Dasovon/MyBot/docs/oled-display-reference.png

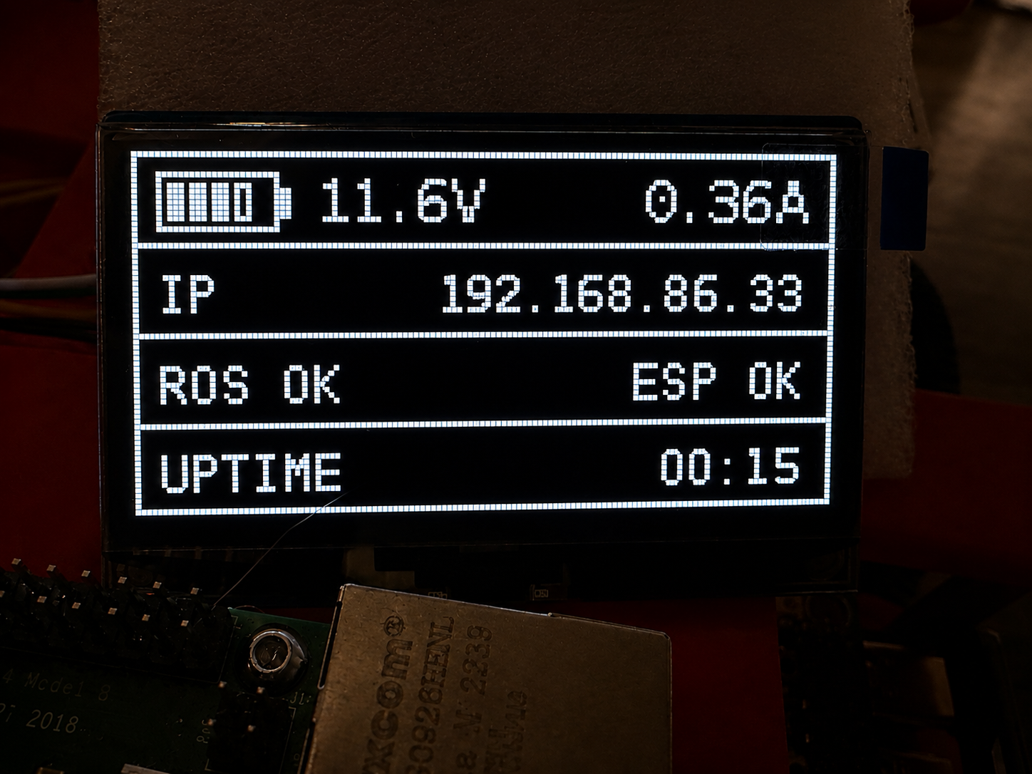
docs/oled-display-reference.png
