Dasovon/MyBot/Hardware/motor.png

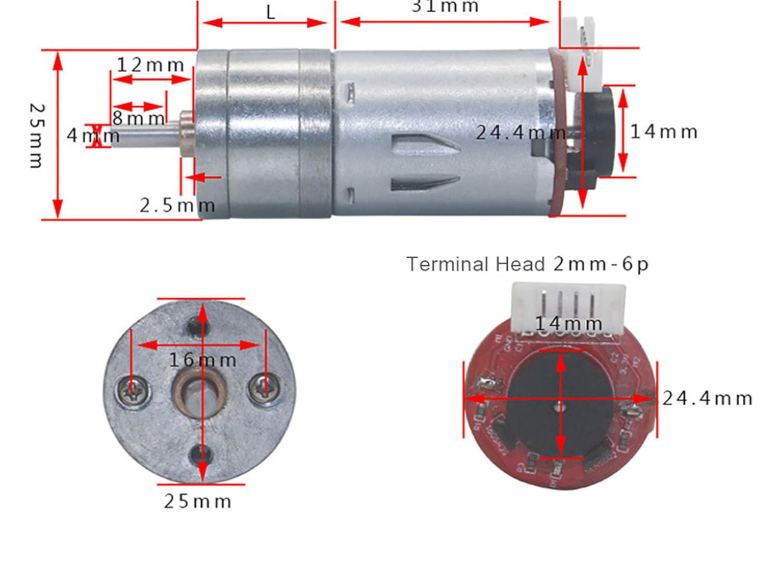
Hardware/motor.png
