Dasovon/MyBot/Hardware/mybot/mybot_back.png

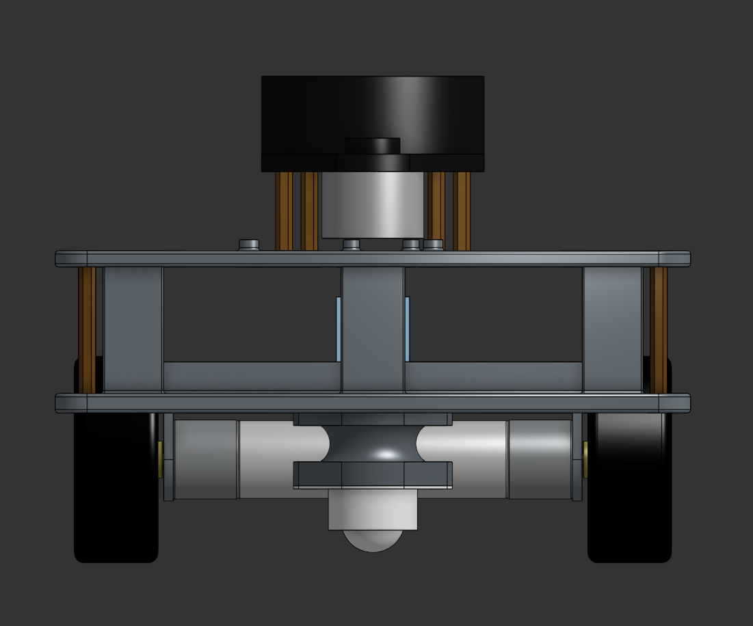
Hardware/mybot/mybot_back.png
