Dasovon/MyBot/Hardware/mybot/mybot_dim.png

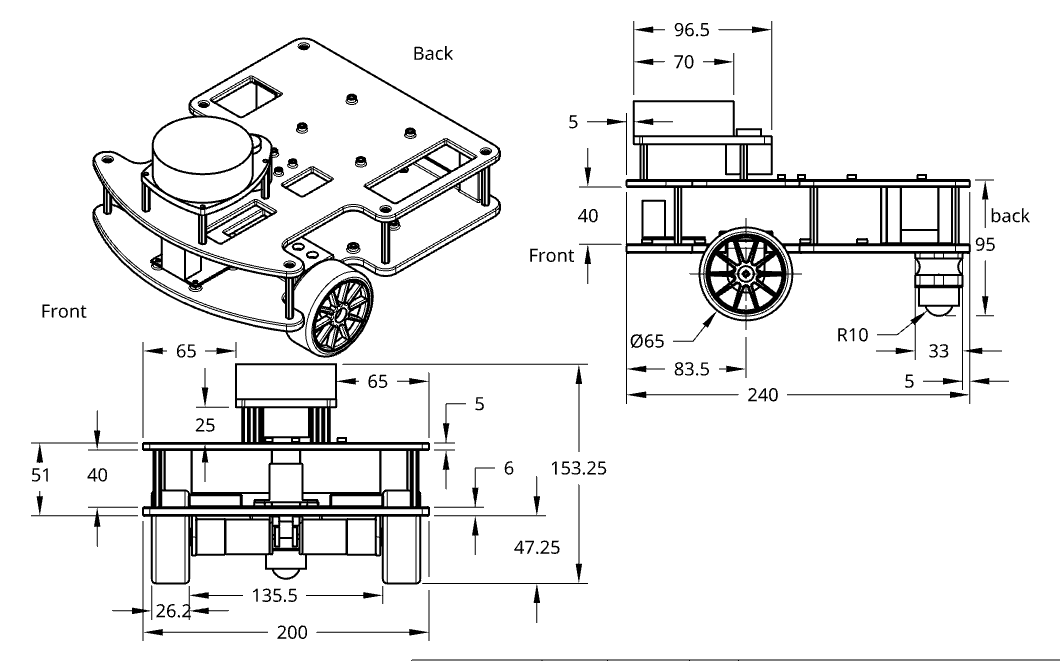
Hardware/mybot/mybot_dim.png
