Dasovon/MyBot/Hardware/mybot/mybot_left.png

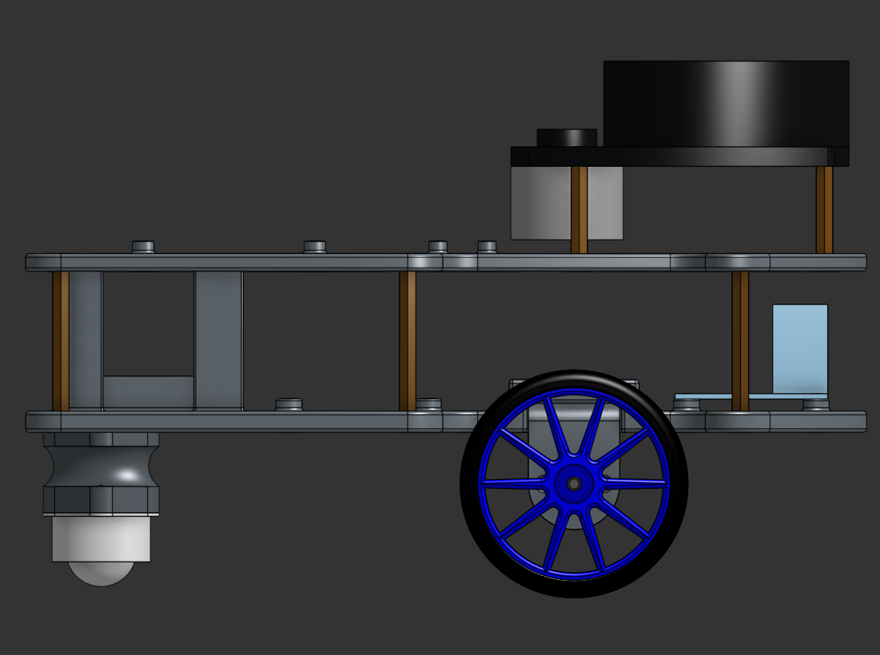
Hardware/mybot/mybot_left.png
