Dasovon/MyBot/docs/test-results/floor-tests/debug-command-path-2026-05-17/after-esp-recovery-attempt/floor_baseline_1_backward.csv

# test_date | 2026-05-17 18:24:48
# profile | one_turn
# command_topic | /cmd_vel_joy
# turn_revolutions | 4.681188
# turn_max_revolutions | 50.0
# turn_extend_revolutions | 1.0
# turn_linear_ms | -0.35
# turn_angular_rads | 0.0
# turn_velocity_floor | 0.5
# turn_adaptive | False
# turn_max_time_s | 14.0
# turn_counts_per_rev | 1010.0
# log_rate_hz | 5.0
# command_rate_hz | 10.0
# warmup_s | 0.5
wall_time | elapsed_s | run | phase | key | label | cmd_lin | cmd_ang | battery_v | current_a | power_w | raw_vx | raw_wz | ekf_vx | ekf_wz | imu_yaw_deg | imu_gyro_z | imu_accel_x | cmd_wheel_l | cmd_wheel_r | enc_cnt_l | enc_cnt_r | enc_tgt_l | enc_tgt_r | enc_act_l | enc_act_r | enc_filt_l | enc_filt_r | turn_goal_cnt
18:24:50 | 2.504 | 1 | active | i | one_turn | 0.0 | 0.0 | 12.12399959564209 | 0.3360000252723694 | 4.073664170537938 | 0.0 | 0.0 | nan | nan | -13.135969546990045 | -0.0625 | 0.06 | 0.0 | 0.0 | 0 | 0 | 0.0 | 0.0 | 0.0 | 0.0 | 0.0 | 0.0 | 4728
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
