Dasovon/MyBot/src/articubot_one/config/my_controllers.yaml

controller_manager:
  ros__parameters:
    update_rate: 30
    # use_sim_time: true

    diff_cont:
      type: diff_drive_controller/DiffDriveController

    joint_broad:
      type: joint_state_broadcaster/JointStateBroadcaster

diff_cont:
  ros__parameters:

    publish_rate: 50.0

    base_frame_id: base_link

    left_wheel_names: ['left_wheel_joint']
    right_wheel_names: ['right_wheel_joint']
    wheel_separation: 0.179
    wheel_radius: 0.034

    use_stamped_vel: false

    # open_loop: false    

    # wheels_per_side: x
    # wheel_separation_multiplier: x
    # left_wheel_radius_multiplier: x
    # right_wheel_radius_multiplier: x

    # odom_frame_id: x
    # pose_covariance_diagonal: x
    # twist_covariance_diagonal: x
    # open_loop: x
    # enable_odom_tf: x

    # cmd_vel_timeout: x
    # publish_limited_velocity: x
    # velocity_rolling_window_size: x
    

    linear.x.has_velocity_limits: true
    linear.x.has_acceleration_limits: true
    linear.x.max_velocity: 0.3
    linear.x.min_velocity: -0.3
    linear.x.max_acceleration: 0.5
    linear.x.min_acceleration: -0.5

    angular.z.has_velocity_limits: true
    angular.z.has_acceleration_limits: true
    angular.z.max_velocity: 3.35
    angular.z.min_velocity: -3.35
    angular.z.max_acceleration: 1.0
    angular.z.min_acceleration: -1.0




# joint_broad:
#   ros__parameters:
