Dasovon/MyBot/src/ros_arduino_bridge/ROSArduinoBridge/motor_driver.ino

/***************************************************************
   Motor driver definitions
   
   Add a "#elif defined" block to this file to include support
   for a particular motor driver.  Then add the appropriate
   #define near the top of the main ROSArduinoBridge.ino file.
   
   *************************************************************/

#ifdef USE_BASE
   
#ifdef POLOLU_VNH5019
  /* Include the Pololu library */
  #include "DualVNH5019MotorShield.h"

  /* Create the motor driver object */
  DualVNH5019MotorShield drive;
  
  /* Wrap the motor driver initialization */
  void initMotorController() {
    drive.init();
  }

  /* Wrap the drive motor set speed function */
  void setMotorSpeed(int i, int spd) {
    if (i == LEFT) drive.setM1Speed(spd);
    else drive.setM2Speed(spd);
  }

  // A convenience function for setting both motor speeds
  void setMotorSpeeds(int leftSpeed, int rightSpeed) {
    setMotorSpeed(LEFT, leftSpeed);
    setMotorSpeed(RIGHT, rightSpeed);
  }
#elif defined POLOLU_MC33926
  /* Include the Pololu library */
  #include "DualMC33926MotorShield.h"

  /* Create the motor driver object */
  DualMC33926MotorShield drive;
  
  /* Wrap the motor driver initialization */
  void initMotorController() {
    drive.init();
  }

  /* Wrap the drive motor set speed function */
  void setMotorSpeed(int i, int spd) {
    if (i == LEFT) drive.setM1Speed(spd);
    else drive.setM2Speed(spd);
  }

  // A convenience function for setting both motor speeds
  void setMotorSpeeds(int leftSpeed, int rightSpeed) {
    setMotorSpeed(LEFT, leftSpeed);
    setMotorSpeed(RIGHT, rightSpeed);
  }
#elif defined L298_MOTOR_DRIVER
  void initMotorController() {
    pinMode(LEFT_MOTOR_ENABLE,   OUTPUT);
    pinMode(LEFT_MOTOR_FORWARD,  OUTPUT);
    pinMode(LEFT_MOTOR_BACKWARD, OUTPUT);
    pinMode(RIGHT_MOTOR_ENABLE,  OUTPUT);
    pinMode(RIGHT_MOTOR_FORWARD, OUTPUT);
    pinMode(RIGHT_MOTOR_BACKWARD,OUTPUT);

    analogWrite(LEFT_MOTOR_ENABLE,  0);
    analogWrite(RIGHT_MOTOR_ENABLE, 0);
    digitalWrite(LEFT_MOTOR_FORWARD,  LOW);
    digitalWrite(LEFT_MOTOR_BACKWARD, LOW);
    digitalWrite(RIGHT_MOTOR_FORWARD,  LOW);
    digitalWrite(RIGHT_MOTOR_BACKWARD, LOW);
  }

  void setMotorSpeed(int i, int spd) {
    boolean reverse = false;

    if (spd < 0) {
      spd = -spd;
      reverse = true;
    }
    if (spd > 255) spd = 255;

    if (i == LEFT) {
      if (reverse) {
        digitalWrite(LEFT_MOTOR_FORWARD,  LOW);
        digitalWrite(LEFT_MOTOR_BACKWARD, HIGH);
      } else {
        digitalWrite(LEFT_MOTOR_FORWARD,  HIGH);
        digitalWrite(LEFT_MOTOR_BACKWARD, LOW);
      }
      analogWrite(LEFT_MOTOR_ENABLE, spd);
    } else {
      if (reverse) {
        digitalWrite(RIGHT_MOTOR_FORWARD,  LOW);
        digitalWrite(RIGHT_MOTOR_BACKWARD, HIGH);
      } else {
        digitalWrite(RIGHT_MOTOR_FORWARD,  HIGH);
        digitalWrite(RIGHT_MOTOR_BACKWARD, LOW);
      }
      analogWrite(RIGHT_MOTOR_ENABLE, spd);
    }
  }

  void setMotorSpeeds(int leftSpeed, int rightSpeed) {
    setMotorSpeed(LEFT, leftSpeed);
    setMotorSpeed(RIGHT, rightSpeed);
  }
#elif defined TB6612_MOTOR_DRIVER
  void initMotorController() {
    pinMode(LEFT_MOTOR_ENABLE,   OUTPUT);
    pinMode(LEFT_MOTOR_FORWARD,  OUTPUT);
    pinMode(LEFT_MOTOR_BACKWARD, OUTPUT);
    pinMode(RIGHT_MOTOR_ENABLE,  OUTPUT);
    pinMode(RIGHT_MOTOR_FORWARD, OUTPUT);
    pinMode(RIGHT_MOTOR_BACKWARD,OUTPUT);

    analogWrite(LEFT_MOTOR_ENABLE,  0);
    analogWrite(RIGHT_MOTOR_ENABLE, 0);
    digitalWrite(LEFT_MOTOR_FORWARD,  LOW);
    digitalWrite(LEFT_MOTOR_BACKWARD, LOW);
    digitalWrite(RIGHT_MOTOR_FORWARD,  LOW);
    digitalWrite(RIGHT_MOTOR_BACKWARD, LOW);
  }

  void setMotorSpeed(int i, int spd) {
    boolean reverse = false;

    if (spd < 0) {
      spd = -spd;
      reverse = true;
    }
    if (spd > 255) spd = 255;

    if (i == LEFT) {
      if (reverse) {
        digitalWrite(LEFT_MOTOR_FORWARD,  LOW);
        digitalWrite(LEFT_MOTOR_BACKWARD, HIGH);
      } else {
        digitalWrite(LEFT_MOTOR_FORWARD,  HIGH);
        digitalWrite(LEFT_MOTOR_BACKWARD, LOW);
      }
      analogWrite(LEFT_MOTOR_ENABLE, spd);
    } else {
      if (reverse) {
        digitalWrite(RIGHT_MOTOR_FORWARD,  LOW);
        digitalWrite(RIGHT_MOTOR_BACKWARD, HIGH);
      } else {
        digitalWrite(RIGHT_MOTOR_FORWARD,  HIGH);
        digitalWrite(RIGHT_MOTOR_BACKWARD, LOW);
      }
      analogWrite(RIGHT_MOTOR_ENABLE, spd);
    }
  }

  void setMotorSpeeds(int leftSpeed, int rightSpeed) {
    setMotorSpeed(LEFT, leftSpeed);
    setMotorSpeed(RIGHT, rightSpeed);
  }
#else
  #error A motor driver must be selected!
#endif

#endif
