Dasovon/MyBot/src/articubot_one/scripts/org01_font.py

#!/usr/bin/env python3

from PIL import Image, ImageDraw

GLYPH_DATA = {
    ' ': (0, 0, 6, 0, 1, []),
    '0': (5, 5, 6, 0, -4, ['#####', '#   #', '#   #', '#   #', '#####']),
    '1': (1, 5, 2, 0, -4, ['#', '#', '#', '#', '#']),
    '2': (5, 5, 6, 0, -4, ['#####', '    #', '#####', '#    ', '#####']),
    '3': (5, 5, 6, 0, -4, ['#####', '    #', '#####', '    #', '#####']),
    '4': (5, 5, 6, 0, -4, ['#   #', '#   #', '#####', '    #', '    #']),
    '5': (5, 5, 6, 0, -4, ['#####', '#    ', '#####', '    #', '#####']),
    '6': (5, 5, 6, 0, -4, ['#####', '#    ', '#####', '#   #', '#####']),
    '7': (5, 5, 6, 0, -4, ['#####', '    #', '    #', '    #', '    #']),
    '8': (5, 5, 6, 0, -4, ['#####', '#   #', '#####', '#   #', '#####']),
    '9': (5, 5, 6, 0, -4, ['#####', '#   #', '#####', '    #', '#####']),
    ':': (1, 4, 2, 0, -3, ['#', ' ', ' ', '#']),
    '.': (1, 1, 2, 0, 0, ['#']),
    'A': (5, 5, 6, 0, -4, ['#####', '#   #', '#####', '#   #', '#   #']),
    'B': (5, 5, 6, 0, -4, ['#### ', '#   #', '#### ', '#   #', '#### ']),
    'C': (5, 5, 6, 0, -4, ['#####', '#    ', '#    ', '#    ', '#####']),
    'D': (5, 5, 6, 0, -4, ['#### ', '#   #', '#   #', '#   #', '#### ']),
    'E': (5, 5, 6, 0, -4, ['#####', '#    ', '#####', '#    ', '#####']),
    'F': (5, 5, 6, 0, -4, ['#####', '#    ', '#####', '#    ', '#    ']),
    'G': (5, 5, 6, 0, -4, ['#####', '#    ', '# ###', '#   #', '#####']),
    'H': (5, 5, 6, 0, -4, ['#   #', '#   #', '#####', '#   #', '#   #']),
    'I': (5, 5, 6, 0, -4, ['#####', '  #  ', '  #  ', '  #  ', '#####']),
    'J': (5, 5, 6, 0, -4, [' ####', '   # ', '   # ', '#  # ', '#####']),
    'K': (5, 5, 6, 0, -4, ['#   #', '# ## ', '##   ', '# ## ', '#   #']),
    'L': (5, 5, 6, 0, -4, ['#    ', '#    ', '#    ', '#    ', '#####']),
    'M': (5, 5, 6, 0, -4, ['#####', '# # #', '# # #', '# # #', '# # #']),
    'N': (5, 5, 6, 0, -4, ['#####', '#   #', '#   #', '#   #', '#   #']),
    'O': (5, 5, 6, 0, -4, ['#####', '#   #', '#   #', '#   #', '#####']),
    'P': (5, 5, 6, 0, -4, ['#####', '#   #', '#####', '#    ', '#    ']),
    'Q': (5, 5, 6, 0, -4, ['#####', '#   #', '#   #', '#  ##', '#####']),
    'R': (5, 5, 6, 0, -4, ['#####', '#   #', '#####', '#  # ', '#  # ']),
    'S': (5, 5, 6, 0, -4, ['#####', '#    ', '#####', '    #', '#####']),
    'T': (5, 5, 6, 0, -4, ['#####', '  #  ', '  #  ', '  #  ', '  #  ']),
    'U': (5, 5, 6, 0, -4, ['#   #', '#   #', '#   #', '#   #', '#####']),
    'V': (5, 5, 6, 0, -4, ['#   #', '#   #', '#   #', ' # # ', '  #  ']),
    'W': (5, 5, 6, 0, -4, ['# # #', '# # #', '# # #', '# # #', '#####']),
    'X': (5, 5, 6, 0, -4, ['#   #', ' # # ', '  #  ', ' # # ', '#   #']),
    'Y': (5, 5, 6, 0, -4, ['#   #', '#   #', ' # # ', '  #  ', '  #  ']),
    'Z': (5, 5, 6, 0, -4, ['#####', '    #', '#####', '#    ', '#####']),
}


def text_width(text, scale=1.0):
    width = 0
    for ch in text:
        width += GLYPH_DATA.get(ch, GLYPH_DATA['?'] if '?' in GLYPH_DATA else GLYPH_DATA[' '])[2]
    return max(0, int(round(width * scale)))


def _draw_text_raw(draw, x, y, text, fill=0):
    baseline = y + 4
    cursor_x = x
    for ch in text:
        width, height, advance, x_off, y_off, rows = GLYPH_DATA.get(
            ch, GLYPH_DATA.get('?', GLYPH_DATA[' '])
        )
        if width and height:
            top = baseline + y_off
            left = cursor_x + x_off
            for row_idx, row in enumerate(rows):
                for col_idx, pixel in enumerate(row):
                    if pixel != '#':
                        continue
                    draw.point((left + col_idx, top + row_idx), fill=fill)
        cursor_x += advance
    return cursor_x - x


def draw_text(draw, x, y, text, fill=0, scale=1.0):
    if scale == 1.0:
        return _draw_text_raw(draw, x, y, text, fill=fill)

    width = max(1, text_width(text))
    height = 9
    base = Image.new('1', (width, height), 1)
    base_draw = ImageDraw.Draw(base)
    _draw_text_raw(base_draw, 0, 0, text, fill=0)
    scaled_w = max(1, int(round(base.width * scale)))
    scaled_h = max(1, int(round(base.height * scale)))
    scaled = base.resize((scaled_w, scaled_h), resample=Image.NEAREST)
    for py in range(scaled_h):
        for px in range(scaled_w):
            if scaled.getpixel((px, py)) == 0:
                draw.point((x + px, y + py), fill=fill)
    return scaled_w
