Dasovon/MyBot/(commit log)

2026-03-16 Initial commit — MyBot ROS 2 Humble workspace
    - articubot_one package (launch, config, description, URDF)
    - ROSArduinoBridge Arduino firmware (L298N + encoder wiring for DC12V 130RPM motors)
    - Hardware documentation and memory files
    - Encoder calibration helper script
    - enc_counts_per_rev updated to 1100 for new motors (pending odom validation)
    [ball_tracker_params_robot.yaml, camera.xacro, depth_camera.xacro, face.xacro, gazebo_control.xacro, inertial_macros.xacro, lidar.xacro, my_controllers.yaml]
2026-03-17 Motor swap, odometry validation, and URDF update to actual dimensions (2026-03-16)
    Motors:
    - Swapped to JGA25-371 45:1 DC12V 130RPM encoder gear motors
    - enc_counts_per_rev validated at 990 via odometry (two runs)
    - Needs re-validation after wheel_radius correction
    URDF / config corrections (robot_core.xacro, lidar.xacro, my_controllers.yaml):
    - wheel_separation: 0.297 → 0.179m (measured center-to-center)
    - wheel_radius: 0.0325 → 0.034m (measured 68mm; datasheet says 65mm)
    - chassis_length: 0.335 → 0.240m
    - chassis_width: 0.265 → 0.1355m
    - wheel_offset_y: 0.1485 → 0.0895m
    - caster_wheel_offset_x: 0.075 → 0.033m
    - lidar xyz: 0.122,0,0.212 → 0.200,0,0.116 (40mm from front, 160mm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
    [lidar.xacro, my_controllers.yaml, robot_core.xacro, ros2_control.xacro]
2026-03-18 Re-validate enc_counts_per_rev with corrected wheel_radius
    3 wall-guided odometry runs (2026-03-17) with wheel_radius=0.034:
    - Run 1: 29.25in actual → 1006
    - Run 2: 37.5in actual → 1016
    - Run 3: 33.625in actual → 1012
    - Average: 1011 → applied 1010
    Previous value of 990 was measured before wheel_radius correction from
    0.0325 → 0.034m (~4.6% scale change). CLAUDE.md updated accordingly.
    [ros2_control.xacro]
2026-03-18 Add RPLidar A1 support and stable USB device names
    - Create udev rules: /dev/arduino (CH340) and /dev/rplidar (CP2102)
    - Update ros2_control.xacro: device /dev/ttyUSB0 → /dev/arduino
    - Update rplidar.launch.py: use /dev/rplidar, add serial_baudrate=115200
    - Lidar verified: health OK, Standard mode, 10Hz scan frequency
    [ros2_control.xacro]
2026-03-18 Fix robot model orientation and add RPLidar to main launch
    URDF orientation fix (chassis was drawn backwards):
    - chassis_joint: add rpy="0 0 pi" rotation, adjust x to chassis_length-wheel_offset_x
    - caster_wheel_offset_x: 0.033 -> 0.207 (now measured from front in flipped chassis frame)
    - lidar.xacro: origin x 0.200 -> 0.040 (40mm from front edge in flipped frame)
    - robot.urdf.xacro: comment out face.xacro inclusion
    RPLidar integration:
    - launch_robot.launch.py: include rplidar.launch.py in main launch
    [lidar.xacro, robot.urdf.xacro, robot_core.xacro]
2026-03-18 Update CLAUDE.md: lidar done, SLAM next
2026-03-18 Update CLAUDE.md: fix history #12, serial device, session notes
2026-03-19 Add SLAM, BNO055 IMU, and robot_localization EKF
    - SLAM with slam_toolbox: fixed mode→mapping, use_sim_time→false,
    max_laser_range→12.0, minimum_travel_distance/heading→0.2
    - Saved map: maps/my_map.pgm + my_map.yaml (200x136 @ 0.05m/pix)
    - BNO055: ros-humble-bno055 on I2C bus 1 at 0x28, config/bno055_params.yaml
    - robot_localization EKF: fuses /diff_cont/odom + /imu/imu → /odom at 20Hz
    - imu_link added to URDF at xyz="0.004 -0.018 0.055"
    - Removed old /diff_cont/odom→/odom remap; EKF now owns /odom
    - Updated CLAUDE.md (fix history #13, #14) and HARDWARE_MEMORY.md
    - Added BNO055 datasheet to Hardware/
    [robot_core.xacro]
2026-03-21 Add RealSense D435, offload EKF/Nav2 to dev machine, tune SLAM and Nav2
    - Add camera.launch.py for RealSense D435 (640x480@15fps, no pointcloud)
    - Add dev_launch.py: runs EKF on dev machine to reduce Pi CPU load
    - Remove EKF from launch_robot.launch.py (now runs on dev)
    - Add Nav2 stack (localization + navigation launch files, Humble API)
    - Raise Nav2 max velocity to 0.4 m/s (was TurtleBot3 default 0.26)
    - Tune SLAM params for small rooms (minimum_time_interval, link_match, loop_match)
    - Update map: 113x140 @ 0.05m/pix (2026-03-21)
    - Update CLAUDE.md: fix #16-18, current status, dev architecture
    [mapper_params_online_async.yaml]
2026-03-22 Fix RealSense D435 color stream and add ball tracker
    - Fix #18 complete: built librealsense v2.56.4 from source with
    FORCE_RSUSB_BACKEND=ON; replaced apt .so in /opt/ros/humble to
    override V4L2/UVC backend — both depth and color streams now at 15 FPS
    - Clone ball_tracker (joshnewans) into dev_ws; fix image_topic remap
    from /camera/image_raw → /camera/camera/color/image_raw for D435
    - CLAUDE.md: update status, document fix #18 steps and key lessons,
    mark "Adding a Camera" tutorial chapter complete
2026-04-26 Switch motor driver from L298N to Adafruit TB6612
    Add TB6612_MOTOR_DRIVER ifdef block with same pin mapping (D5/D6/D7/D8/D9/D10)
    and identical PWM+direction logic. Same physical wiring, different driver chip.
2026-04-26 Docs: update for TB6612 motor driver swap
    Update CLAUDE.md and HARDWARE_MEMORY.md to reflect Adafruit TB6612
    replacing L298N — pin mapping, firmware define, fix history, block diagram.
2026-04-26 Docs: TB6612 first unit damaged by overvoltage on AIN1/BIN1
    Document root cause (12V on logic input pins), symptoms, diagnosis method,
    and what to check before installing replacement chip.
2026-04-26 Fix TB6612 pin mapping: swap motors and invert direction
    Encoder tests revealed PWMA/AIN drives right motor and PWMB/BIN drives
    left motor (physically swapped). xIN2=HIGH is forward for both channels.
    [motor_driver.h]
2026-04-26 Fix TB6612 wiring table left/right label flip; document VCC logic thresholds
    Motor A (PWMA/AIN1/AIN2) drives the RIGHT motor and Motor B (PWMB/BIN1/BIN2)
    drives the LEFT motor — the wiring table had these labels swapped relative to
    the firmware pin defines. Also adds VCC to the wiring table with a note that
    all TB6612 signal thresholds are validated against VCC, so it must match MCU
    logic voltage (5V for Arduino Nano; 3.3V for ESP32, no level shifter needed).
    https://claude.ai/code/session_01JZxLh9r5mjwfbjnuEyVAhU
2026-04-26 Add ESP32 micro-ROS firmware scaffold (motor control + BNO055)
    Self-contained PlatformIO project in src/esp32_microros/. No existing
    files touched. Publishes /diff_cont/odom and /imu/imu, subscribes to
    /diff_cont/cmd_vel_unstamped — same topics as current Arduino stack so
    Pi-side EKF, Nav2, and AMCL require no changes.
    PID gains seeded from validated Arduino values (Kp=20, Kd=12, Ki=0).
    Encoder ISR direction matches fix #7. Requires micro_ros_agent on Pi:
    ros2 run micro_ros_agent micro_ros_agent serial --dev /dev/ttyUSB0
    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
    [main.cpp]
2026-04-26 Update docs and README for ESP32 micro-ROS branch
    - README: rewrite to reflect current hardware (TB6612 not L298N, Nav2
    working, BNO055, RealSense); add esp32_microros to workspace structure
    - HARDWARE_MEMORY: fix motor channel labels (Motor A = RIGHT, Motor B = LEFT);
    add full ESP32 wiring tables and micro-ROS agent command
    - docs/workflow.md: add ESP32 micro-ROS testing section with flash, verify,
    and switchback instructions
    - docs/pin-mapping.md: new file — full pin tables for both Arduino and ESP32
    hardware paths, GPIO caveats, ISR direction notes
    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
2026-04-26 Add ESP32 component test sketches
    Four standalone PlatformIO projects in src/esp32_microros/test/:
    - test_bno055: I2C reads, quaternion/gyro/accel output, calibration status
    - test_encoders: pulse counting with velocity estimate, direction mismatch
    detection, 'r' to reset
    - test_motors: safety-gated test sequence (forward/reverse per motor, PWM
    ramp), manual f/b/l/r/s control; includes pre-flight checklist for
    replacement TB6612 chip
    - test_microros: agent connection state machine with LED feedback, heartbeat
    counter on /esp32/heartbeat, cmd_vel subscriber; Pi-side verify commands
    in comments
    Each sketch is independent — no micro-ROS dependency except test_microros.
    https://cl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
    [main.cpp]
2026-04-26 Update CLAUDE.md with 2026-04-26 session work
    - Where we are now: update date, TB6612 status, ESP32 branch status, ordered next steps
    - Active branches: add feature/esp32-microros and claude/document-vcc-logic-thresholds
    - Directory structure: add esp32_microros/ tree with test sketch layout
    - Current status: add ESP32 experiment entry and label fix entry
    - Fix #20: TB6612 wiring table label correction (Motor A=RIGHT, Motor B=LEFT)
    - Fix #21: ESP32 micro-ROS scaffold — pin mapping, topics, flash commands, status
    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
2026-04-26 Add test_bno055 sketch for ESP32 I2C validation
    Standalone PlatformIO sketch (no micro-ROS) that confirms BNO055
    is wired and responding before flashing full firmware.
    https://claude.ai/code/session_01DwZ5af26dRz936bHStCzpJ
2026-04-27 Update CLAUDE.md: ESP32 test session 2026-04-27
    - Status updated: Windows machine set up, test_bno055 flashed to ESP32
    - Next steps updated: BNO055 wiring → encoder test → motor test → micro-ROS
    - Fix #22 added: Windows dev setup + test_bno055 sketch details
    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
2026-05-03 fix(firmware): restore TB6612 right motor pins and fix left encoder direction
    Replacement TB6612 motor wiring was corrected — both wires now on MOTORA/MOTORB
    output pads (not GND pad). Right motor Arduino pins reverted from debug-test
    positions (D11/A0/A1) to original D5/D6/D7. Left encoder ISR inverted (A==B →
    A!=B) so forward rotation gives positive counts. All four directions validated.
    [encoder_driver.ino, motor_driver.h]
2026-05-03 fix(firmware): invert left motor direction and restore left encoder ISR
    Left wheel was running backward — robot rotated instead of driving forward.
    Swapped LEFT_MOTOR_FORWARD/BACKWARD (BIN1↔BIN2) and reverted left encoder
    ISR back to A==B to keep positive counts for forward rotation. Validated:
    robot drives forward on 'i', turns correctly on 'j'/'l'.
    [encoder_driver.ino, motor_driver.h]
2026-05-03 docs: update CLAUDE.md with teleop validation and final motor direction fix
2026-05-03 tune: lower linear max to 0.3 m/s, raise angular max to 2.5 rad/s
    Balances teleop feel — forward was faster than turns because angular cap
    was 1.0 rad/s and all teleop values above it got clamped to the same speed.
    [my_controllers.yaml]
2026-05-03 tune: match angular max to linear max wheel speed (3.35 rad/s)
    angular_max = 2 * linear_max / wheel_separation = 2 * 0.3 / 0.179 = 3.35
    This ensures full-speed turning uses the same wheel velocity as full-speed
    straight driving.
    [my_controllers.yaml]
2026-05-04 docs: update all hardware docs with TB6612 validation and velocity tuning
    - CLAUDE.md: fix #21 entry, updated current status to 2026-05-03
    - HARDWARE_MEMORY.md: motor driver status, correct FORWARD/BACKWARD pins,
    velocity tracking validation results
    - docs/pin-mapping.md: corrected firmware pin defines (BIN1=FWD, BIN2=BWD),
    motor output wiring warning, velocity tracking data
2026-05-04 docs: add final velocity tracking validation data (3 confirmed runs)
    Forward and spin track 88-98% at operating speeds, symmetric within
    0.002 m/s left/right. Low-speed deadband at 25% is normal for DC motors.
2026-05-04 docs: add IMU axis validation and circle test results
    BNO055 axes confirmed (x=forward, z=yaw). Circle test: 0.94 IMU/cmd
    ratio, 24.6 cm closure error open-loop. README updated with current
    validated status table.
2026-05-04 docs: update next steps — lidar test + sensor calibration next session
2026-05-05 launch: disable camera node when not connected
2026-05-05 ekf: add process noise covariance matrix to fix numerical instability
    [ekf.yaml]
2026-05-05 amcl: tune params for better localization convergence
    Increase particles 2000→5000, update thresholds 0.25/0.2→0.1/0.1,
    tighten laser model (sigma_hit 0.2→0.1, z_hit 0.5→0.8, z_rand 0.5→0.15),
    enable recovery (alpha_fast=0.1, alpha_slow=0.001).
2026-05-05 docs: update status — nav stack validated 2026-05-04
2026-05-05 docs: add Nav2 navigation test and Jetson Nano to next steps
2026-05-05 session 2026-05-05: new map, Nav2 goal confirmed, architecture clarified
    - New room map saved: 232x321 @ 0.025 m/pix
    - Nav2 autonomous goal send → SUCCEEDED
    - Clarified current architecture: Arduino = motor driver only,
    BNO055 on Pi I2C-1 (temporary), ESP32 migration pending
    - All sensors verified healthy (RPLIDAR, Arduino, BNO055)
    - Copied map files to dev machine ~/mybot_ws/maps/
2026-05-05 re-enable RealSense camera in launch_robot.launch.py
    D435 re-connected — uncomment camera node.
2026-05-05 auto USB reset for RealSense D435 on launch
    - Add uhubctl power cycle (hub 2 port 2) as first launch action
    - Camera node delayed 6s to allow USB re-enumeration
    - Eliminates need for physical replug after Pi reboot
2026-05-05 increase RealSense USB reset and launch delays
    Power cycle: off 3s → on 6s wait (was 2s/3s)
    Camera launch delay: 6s → 12s after reset completes
2026-05-05 wait for D435 USB enumeration in reset script, bump camera delay to 20s
2026-05-05 add initial_reset to RealSense camera launch
    Forces firmware reset before streaming to fix color stream XU
    control failures after repeated node restarts.
2026-05-05 force camera image topics to VOLATILE QoS
    TRANSIENT_LOCAL was incompatible with image_transport, rqt_image_view,
    and standard ROS 2 subscribers. VOLATILE allows compressed republishing
    and normal topic tools to work across the network.
2026-05-05 fix(camera): disable IR streams, remove initial_reset, add VOLATILE QoS for network image transport
    Fixes RealSense D435 streaming to dev machine (fix #24):
    - Remove initial_reset:true — caused soft re-enumeration that broke color sensor XU state
    - Disable IR streams (enable_infra1/2: false) — not needed for object tracking, fits USB 2.0 bandwidth
    - Add VOLATILE QoS overrides on color + depth topics — fixes DDS incompatibility with cross-network subscribers
    - Update CLAUDE.md with USB authorization reset approach and camera streaming status
    USB reset approach is in ~/reset_realsense.sh on Pi (not in git):
    uses echo 0/1 to /sys/bus/usb/devices/*/authorized to clear endpoint stalls with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
2026-05-08 feat(ina219): add battery state publisher node via Pi I2C
    - ina219_node.py: reads voltage + current from INA219 at 0x40 (I2C bus 1),
    publishes sensor_msgs/BatteryState on /battery_state at 1Hz
    - CMakeLists.txt: install scripts/ina219_node.py as executable
    - launch_robot.launch.py: add ina219 node to Pi launch
    INA219 (ACEIRMC, 0.1Ω shunt) wired to Pi I2C-1 (GPIO 2/3),
    shares bus with BNO055 at 0x28. INA219 address 0x40.
2026-05-08 docs: session wrap-up 2026-05-07 — INA219 confirmed working
    11.38V / +0.21A at idle verified. Correct polarity (VIN+ on battery+).
2026-05-10 feat(esp32): update test_bno055 sketch for ESP32-S3-DevKitC-1
    Switch board from esp32dev to esp32-s3-devkitc-1 and update I2C pins
    from GPIO21/22 (not broken out on S3) to GPIO8/9 (default S3 I2C).
    BNO055 confirmed working on Lonely Binary expansion base.
    [main.cpp]
2026-05-10 Revert "feat(esp32): update test_bno055 sketch for ESP32-S3-DevKitC-1"
    This reverts commit 27e644cb50d7cc14c79be0bad9b0c8e4cdeea19e.
    [main.cpp]
2026-05-10 feat(esp32): add WiFi OTA to test_bno055 sketch
    ArduinoOTA on hostname esp32-mybot. USB env (esp32-s3) unchanged;
    new env esp32-s3-ota uploads via espota to esp32-mybot.local.
    credentials.h gitignored — fill in SSID/password locally before
    first USB flash.
2026-05-10 feat(esp32): add WiFi OTA, telnet monitor, and INA219 to test_bno055
    - ArduinoOTA over WiFi (hostname esp32-mybot, port espota)
    - TelnetStream on port 23 for wireless serial monitoring (nc esp32-mybot.local 23)
    - INA219 battery monitor on shared I2C bus (0x40) confirmed working
    - BNO055 + INA219 both confirmed on ESP32-S3 at 11.4V / ~40-70mA
    - credentials.h gitignored — fill in locally before first USB flash
2026-05-10 docs: update CLAUDE.md with ESP32 status and Windows dev setup
    - Current status: BNO055 + INA219 confirmed on ESP32-S3, OTA + telnet working
    - Windows setup: CH340 driver, VS Code + PlatformIO, clone/checkout steps,
    credentials.h instructions, first USB flash and OTA workflow
    - gitignore: add .vscode/ for esp32_microros sketches
2026-05-10 docs: overhaul README, CLAUDE.md, and add esp32_microros README
    - README.md: full rewrite with badges, status table, power architecture
    diagram, hardware table (DFR0205 added), architecture ASCII, and
    per-sketch ESP32 test status
    - src/esp32_microros/README.md: new embedded project README covering
    pin mapping, bench test progression, OTA flash workflow, and
    micro-ROS topic reference
    - CLAUDE.md: merged concise CLAUDE_1.md structure with full fix history,
    Windows ESP32 dev setup, Windows machine added to machines table,
    INA219 added to ESP32 pin mapping (GPIO8/9 shared with BNO055)
    - HARDWARE_MEMORY.md: power architecture updated with DFR0205 details
    and full power chain (batter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
2026-05-10 docs(hardware): add full component reference library
    New Hardware/ folder structure with docs for all 10 components:
    - Hardware/README.md — master index, system block diagram, power budget
    - compute/raspberry-pi-4.md — GPIO pinout, USB assignments, udev, I2C devices
    - compute/arduino-nano.md — pinout, motor/encoder wiring, firmware, flash cmd
    - microcontroller/esp32-s3-devkitc-1.md — pin assignments, OTA workflow, GPIO restrictions
    - motor-system/tb6612-driver.md — full pinout, direction table, Arduino+ESP32 wiring, damage warning
    - motor-system/jga25-371-motors.md — wire colors, encoder ISR, odometry formula
    - sensors/bno055-imu.md — Pi + ESP32 wiring, ROS con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
2026-05-10 docs(hardware): add DFR0205 board diagram with white background
    White background added so annotation text is readable in both light
    and dark markdown preview themes.
2026-05-10 fix(esp32): retry INA219 begin() on boot failure
    INA219 was silently failing begin() on some boots despite being present
    on I2C. Added same retry-loop pattern as BNO055.
    [main.cpp]
2026-05-10 fix(esp32): correct pin assignments for ESP32-S3 in test_encoders and test_motors
    GPIO25/26/27/32/33/34/35/36/39 don't exist on ESP32-S3. Updated to valid S3 pins:
    - TB6612: PWMA=1, AIN1=2, AIN2=4, PWMB=5, BIN1=6, BIN2=7
    - Encoders: L_A=40, L_B=41, R_A=42, R_B=43
    - Updated CLAUDE.md pin table
    [main.cpp]
2026-05-10 fix(esp32): correct pins for Lonely Binary expansion base
    GPIO4/5/6/7 not broken out on this board. Updated to available pins:
    - TB6612: PWMA=10, AIN1=11, AIN2=12, PWMB=13, BIN1=14, BIN2=15 (left side)
    - Encoders: L_A=40, L_B=41, R_A=42, R_B=39 (right side)
    - Updated CLAUDE.md with board pin layout
    [main.cpp]
2026-05-10 feat(esp32): add WiFi OTA and telnet to test_encoders and test_motors
    - Board corrected to esp32-s3-devkitc-1 (was esp32dev)
    - ArduinoOTA + TelnetStream on port 23
    - Commands (r / f b l r s g) work from both USB serial and telnet
    - credentials.h gitignored — copy from test_bno055/src/
    [main.cpp]
2026-05-10 fix(esp32): use legacy LEDC API in test_motors
    ledcAttach() is new API (core 3.x+). Replace with ledcSetup/ledcAttachPin/ledcWrite
    using explicit channels. Motors confirmed working on ESP32-S3.
    [main.cpp]
2026-05-10 feat(esp32): update test_microros for WiFi UDP transport + OTA + telnet
    - Board: esp32-s3-devkitc-1 (was esp32dev)
    - Transport: WiFi UDP to Pi agent at 192.168.86.33:8888 (was UART)
    - Added ArduinoOTA + TelnetStream for wireless flashing and monitoring
    - Agent start command: ros2 run micro_ros_agent micro_ros_agent udp4 --port 8888
2026-05-10 test_microros: switch to USB serial transport via micro_ros_platformio
    Replaces micro_ros_arduino (no ESP32-S3 precompiled lib) with
    micro_ros_platformio which builds libmicroros.a for the exact target.
    Transport changed from WiFi UDP to USB serial (HWCDC via ttyACM0).
    ARDUINO_USB_CDC_ON_BOOT=1 routes Serial to the native USB JTAG port.
    WiFi retained for OTA flashing and TelnetStream monitoring only.
    Ping timeout increased 100ms/1 → 500ms/3 for stable HWCDC link.
    [main.cpp]
2026-05-10 docs: update all docs with ESP32-S3 bench test results and USB transport
    - CLAUDE.md: status updated to 2026-05-10 with all bench tests confirmed;
    fixes #22 (Lonely Binary pin corrections) and #23 (micro_ros_platformio +
    HWCDC USB transport, penv workaround, ping timeout fix); agent command
    updated to ttyACM0 with microros_ws source
    - docs/pin-mapping.md: replaced stale ESP32-DevKitC section with correct
    Lonely Binary Expansion Base pins (GPIO10-15 motors, GPIO39-42 encoders,
    GPIO8/9 I2C); LEDC legacy API note; HWCDC transport details
    - HARDWARE_MEMORY.md: replaced placeholder ESP32 wiring block with validated
    Lonely Binary pin assignments and USB transport setup
    - README.md: sta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
2026-05-10 esp32: full production firmware — encoders + PID + odom + BNO055 + INA219 + micro-ROS
    Replaces scaffold with complete firmware combining all validated components.
    Correct ESP32-S3 board, micro_ros_platformio library, HWCDC serial transport,
    WAITING/CONNECTED state machine, 30Hz control loop, 1Hz battery publish.
    [main.cpp]
2026-05-10 feat(launch): replace ros2_control/bno055 with ESP32 micro_ros_agent
    Remove controller_manager, diff_drive_spawner, joint_broad_spawner,
    and bno055 node. Add micro_ros_agent node (serial /dev/ttyACM0).
    ESP32 now owns odometry, IMU, and battery monitoring.
2026-05-11 Fix motor cross-wiring runaway, retune PID, add coast-to-stop; migrate Pi launch to micro_ros_agent
    - Revert PWMA/PWMB swap that created cross-coupled positive feedback loop
    - Reduce Kp 100→30 to prevent turn oscillation; retain Ki=150 for deadband
    - Add coast-to-stop: PID returns 0 when target<0.01 (no hard braking jerk)
    - Migrate launch_robot.launch.py from ros2_control to micro_ros_agent
    - CLAUDE.md: document fixes #25/#26, update status to driving validated
    [main.cpp]
2026-05-11 Update hardware docs to reflect ESP32-S3 production stack
    - esp32-s3-devkitc-1.md: correct GPIO pins (TB6612: 10-15, enc: 40/41/42/39), HWCDC transport (ttyACM0), 30Hz topic rates, pins-to-avoid table
    - tb6612-driver.md: correct ESP32 GPIO pins in wiring table, mark as production
    - raspberry-pi-4.md: update node list (micro_ros_agent replaces ros2_control stack), USB table (ttyACM0), remove Pi I2C section (moved to ESP32)
    - Hardware/README.md: update system diagram, ESP32-S3 → Production, Arduino Nano → Retired, power budget
    - HARDWARE_MEMORY.md: update system block diagram and bringup sequence for ESP32 stack
    - docs/workflow.md: update what-runs-where, emergency stop procedure, ESP32 se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
2026-05-14 docs(esp32): fix README — correct pins, status, rates, agent device
    - Motor pins updated to Lonely Binary base: PWMA/B→10/13, AIN/BIN→11/12/14/15
    - Encoder pins updated: L_A/B→40/41, R_A/B→42/39
    - All test sketch status: ⬜ pending → ✅ confirmed (validated 2026-05-09/10)
    - Publish rates: ~20 Hz → ~30 Hz (matches 33ms control loop)
    - Agent device: /dev/ttyUSB0 → /dev/ttyACM0 (HWCDC native USB)
    - Pins to avoid: updated for ESP32-S3 + Lonely Binary board constraints
    - I2C note: updated to explain Lonely Binary unexposed GPIOs
    - Library: micro_ros_arduino → micro_ros_platformio
2026-05-14 docs(display): update OLED docs to SPI mode with official Waveshare pinout
    - Switch all wiring from I2C to SPI (no resistor swap needed — module ships in SPI)
    - Correct DC→GPIO25 (pin 22) and RST→GPIO27 (pin 13) from official Waveshare wiki
    - Update luma.oled code to spi() interface with correct gpio_DC/gpio_RST
    - Add product photo (oled-2.42inch.png)
    - Add display to Hardware/README.md component index, power budget, and system diagram
2026-05-14 docs(display): add wire colors to OLED wiring tables
    Red=VCC, Black=GND, Blue=DIN, Yellow=CLK, Orange=CS, Green=DC, White=RST
2026-05-14 feat(display): add OLED display ROS 2 node
    oled_display_node.py subscribes to /battery_state, /diff_cont/odom,
    /odom (EKF), and /navigate_to_pose/_action/status, then renders a
    5-line 128x64 status dashboard at 2 Hz via luma.oled SPI (ssd1309,
    GPIO25=DC, GPIO27=RST).
    Layout: hostname/IP | battery V+A | velocity | EKF pose | status line
    Status line: AGENT OFFLINE / TELEOP / IDLE / NAVIGATING / GOAL REACHED
2026-05-14 fix: mark oled_display_node.py executable
    [oled_display_node.py]
2026-05-14 fix: switch OLED interface from SPI to I2C
    Module resistors (R2/R3) are in the I2C position from the factory.
    Wire change: DIN→pin3(SDA), CLK→pin5(SCL), CS→GND.
    DC pin stays at GPIO25 (I2C address select, LOW=0x3C).
    [oled_display_node.py]
2026-05-14 fix: revert OLED to SPI — resistors confirmed in SPI position
    Module is SPI from factory. DC wire (green) was on wrong pin
    (pin 21 MISO instead of pin 22 GPIO25). Code reverts to SPI interface.
    [oled_display_node.py]
2026-05-14 fix: rewrite OLED node using spidev+RPi.GPIO, drop luma.oled
    luma.oled ssd1309 is an alias for ssd1306 — sends SSD1306 charge pump
    command (0x8D 0x14) which corrupts SSD1309 init. Replaced with bare-metal
    spidev + RPi.GPIO using the correct Waveshare SSD1309 init sequence.
    Page-based pixel rendering matches Waveshare convention (black=lit).
    [oled_display_node.py]
2026-05-14 docs: update OLED docs and CLAUDE.md — display working
    - Hardware doc: replace luma.oled instructions with correct spidev approach,
    document why luma.oled fails on SSD1309 (SSD1306 charge pump command)
    - CLAUDE.md: mark OLED display complete, update date to 2026-05-14
2026-05-14 fix: use UDP socket trick to get real network IP on display
    socket.gethostbyname(hostname) returns 127.0.1.1 on Ubuntu due to
    /etc/hosts. UDP connect to 8.8.8.8 asks the OS routing table for
    the correct outbound interface IP without sending any packets.
    [oled_display_node.py]
2026-05-14 docs: document Waveshare 2.42" OLED implementation (2026-05-14)
    Add complete OLED hardware/software documentation. Key decisions:
    - spidev + RPi.GPIO directly (not luma.oled — its ssd1309 class is broken)
    - systemd service at boot, not in launch_robot.launch.py
    - UDP socket trick for real network IP on Ubuntu 22.04
    Also updates BNO055 section to reflect move from Pi I2C to ESP32 I2C,
    corrects power architecture diagram, and marks OLED status as Production.
2026-05-14 fix: add 4px left margin on OLED display to prevent character clipping
    DejaVu Sans V/W/Y strokes clip at x=0; 4px margin prevents cutoff.
    [oled_display_node.py]
2026-05-14 fix: hold RST LOW before SPI open to prevent spurious boot init failure
    On first boot GPIO27 (RST) is a floating input, letting the SSD1309
    receive noise when the SPI clock transitions to its mode-3 idle state.
    Fix: drive RST LOW with initial=GPIO.LOW before opening spidev, then
    hold for 100ms before the reset pulse, and extend post-reset settle to
    200ms. Adds 'Display init OK' log to confirm completion.
    [oled_display_node.py]
2026-05-14 debug: fill display inside _init_display to isolate boot SPI issue
    [oled_display_node.py]
2026-05-14 debug: replace fill with 0xA5 (entire display ON) to test command path
    [oled_display_node.py]
2026-05-14 docs: session end — document OLED boot bug and Pi SD card status
    oled-display.service disabled on Pi. SD card likely corrupted from
    rapid reboots during debug. OLED works after systemctl restart but
    not on first boot — root cause unknown, key facts documented.
2026-05-15 docs: session end — Pi fully restored, OLED hardware issue identified
    Pi reflashed and fully restored (ROS Humble, mybot_ws, microros_ws,
    librealsense RSUSB, udev rules). Robot stack confirmed running with
    ESP32-S3. OLED: RST wire was on wrong pin (11→13 fixed), all software
    paths exhausted with no display response — hardware issue suspected
    (weak VCC or loose FFC).
2026-05-15 Fix OLED init: replace 0xA5 debug diagnostic with 0xA4 resume-to-GDDRAM
    [oled_display_node.py]
2026-05-15 Add Pi setup guide: full restore from blank SD card to running stack
    Covers ROS Humble, micro-ROS agent, librealsense RSUSB build, udev rules,
    SPI enable, OLED display, user groups (critical sudo/GPIO gotcha), and
    common failure modes discovered during 2026-05-14 reflash.
2026-05-15 Update CLAUDE.md: OLED display working, document root cause (GPIO group membership)
    Root cause: RPi.GPIO silently does nothing without gpio/spi group membership.
    Fix: usermod -aG gpio,spi,i2c,dialout + re-login. oled-display.service now enabled.
2026-05-15 Fix OLED init: use page addressing mode, clean up init sequence
    _show() uses page addressing commands (0xB0+page). Init was sending
    0x20 0x00 (horizontal mode) which caused those commands to be ignored
    on cold boot. Changed to 0x20 0x02 (page mode). Also added missing
    standard SSD1309 commands (0x40 start line, 0xA1 seg remap, 0xC8 COM
    scan, 0x81 contrast) and removed spurious 0xFF command.
    [oled_display_node.py]
2026-05-15 Fix OLED cold-boot: drive all pixels ON for 1s during init to charge pump
    On cold power-on the SSD1309 charge pump capacitors are uncharged.
    Init commands succeed without error but pixels can't be driven until
    the pump has charged. 0xA5 forces all pixels ON, giving the capacitors
    1s to charge before switching to GDDRAM rendering with 0xA4.
    [oled_display_node.py]
2026-05-15 Reduce SPI speed to 100kHz for cold-boot reliability
    At 1MHz the display doesn't respond on cold power-on. At 100kHz it
    works. SSD1309 supports up to 10MHz but 1MHz is unreliable while
    the Pi SPI hardware and display are still settling at cold boot.
    [oled_display_node.py]
2026-05-15 Fix OLED cold-boot: prime SPI with dummy byte before init sequence
    The first SPI transaction after a fresh kernel SPI controller init
    at cold boot is unreliable. A sacrificial 0x00 byte (sent while RST
    is LOW so display ignores it) primes the controller before the real
    init sequence. Also reduce A5 warmup hold from 5s back to 1s.
    [oled_display_node.py]
2026-05-15 Document OLED cold-boot fixes in pi-setup and HARDWARE_MEMORY
    Three root causes fully documented: GPIO group membership (silent failure),
    SPI controller cold-boot priming (dummy byte), SPI speed (100kHz not 1MHz).
    Updated service file in pi-setup to match current working config with
    ExecStartPre=sleep 5 and Type=simple.
2026-05-15 fix oled display: add DDS self-restart and FastDDS UDP profile docs
    Root cause: oled service starts at boot before ESP32 connects.
    FastDDS SHM transport prevented endpoint renegotiation with
    late-joining micro_ros_agent publishers, leaving all data fields
    showing '--' and status showing 'AGENT OFFLINE'.
    - oled_display_node.py: exit with code 1 after 30s with no data so
    systemd restarts until the robot stack is live (os._exit avoids
    rclpy shutdown race)
    - docs/pi-setup.md: add fastdds_no_shm.xml creation (§15a), update
    service file with FASTRTPS_DEFAULT_PROFILES_FILE, add DDS timing
    issue to Common Issues, add fastdds xml to files-not-in-git table
    - CLAUDE.md: update OLED status lin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
    [oled_display_node.py]
2026-05-15 fix oled: remove FastDDS UDP-only profile, use default SHM+UDP
    UDP-only profile broke matching with micro_ros_agent (SHM transport).
    Default FastDDS (SHM+UDP) works correctly — odom callback fires at 1.1s,
    battery at 1.6s after node restart while ESP32 is connected.
    The 30s self-restart loop in the node is the only timing fix needed:
    if no data arrives, os._exit(1) triggers systemd restart until live.
2026-05-15 fix oled cold-boot SPI: close+reopen after dummy write
    Single dummy byte wasn't enough to settle the kernel SPI controller
    on first boot. Close+reopen forces the kernel to fully re-apply the
    mode/speed config before the real init sequence runs.
    [oled_display_node.py]
2026-05-15 docs: add fix #28 — oled SPI cold-boot close+reopen
    Documents the root cause and fix for blank display on first boot.
2026-05-15 fix ESP32: auto-restart after 30s without agent
    HWCDC (native USB) doesn't recover cleanly when Pi reboots and the USB
    host re-enumerates. After 30s in WAITING state with no ping response,
    esp_restart() gives a clean re-init of the USB CDC stack.
    [main.cpp]
2026-05-15 docs: add fix #29 (ESP32 watchdog), robot-launch.service, fully auto boot
    - CLAUDE.md: fix #29 — ESP32 30s WAITING watchdog (esp_restart on HWCDC
    reconnect failure); update current state to reflect auto-boot
    - docs/pi-setup.md: new §16 robot-launch.service creation steps; §18
    Verify section adds robot-launch status check; Common Issues adds ESP32
    reconnect watchdog entry; section numbers updated (16/17 → 17/18)
2026-05-15 docs: update CLAUDE.md to reflect completed ESP32 migration and auto-boot
    - Project description: "migration in progress" → production ESP32-S3 stack
    - What runs where: updated for ESP32 (motors/encoders/IMU) vs Pi (agent/lidar/camera)
    - Launch sequence: Pi step 1 auto-starts at boot via robot-launch.service
    - Repos/branches: removed feature/esp32-microros (merged to main), clarified legacy deps
2026-05-15 fix rplidar: switch to rplidar_node, drop scan_mode param
    rplidar_composition consistently fails with 80008002 on A1 M8.
    rplidar_node works correctly after USB sysfs reset in ExecStartPre.
2026-05-15 fix rplidar: 8s startup delay + rplidar_node; revert USB reset from service
    - launch_robot.launch.py: wrap lidar in TimerAction(8s) so motor spins
    up before the node tries to connect (fixes 80008000 timeout on boot)
    - rplidar.launch.py: rplidar_node instead of rplidar_composition, no
    scan_mode param (auto-detect works; composition fails with 80008002)
    - robot-launch.service: removed USB sysfs authorized reset (caused hub
    disruption and knocked RealSense off the bus)
2026-05-15 docs: add fix #30 — rplidar_node + 8s delay fixes startup scan failure
2026-05-15 fix ekf.yaml: change integer 0 to 0.0 in covariance matrix
    ROS2 YAML parser requires uniform types in sequences.
    Mixed int/float caused parse failure at startup.
    [ekf.yaml]
2026-05-15 feat(esp32): add velocity slew-rate limiter (soft start/stop)
    Restores the 0.5 m/s² linear / 1.0 rad/s² angular acceleration limits
    that were previously applied by diff_drive_controller in my_controllers.yaml.
    Those limits were lost when migrating from ros2_control to micro-ROS;
    cmd_vel step changes hit the PID directly, causing jerky turns.
    cmd_cb now stores des_lin/des_ang; the 30 Hz control loop ramps ramp_lin/
    ramp_ang toward them each tick before computing PID wheel targets. Both
    desired and ramped states reset to 0 on agent connect/disconnect.
    [main.cpp]
2026-05-15 revert(esp32): remove velocity slew-rate limiter
    The ramp kept PWM below motor deadband (~30-50) during ramp-up:
    at ramp_ang=0.033 rad/s, Kp*err = 2.6 PWM — motor stalls, then jolts
    when the combined Kp*err + Ki*integral finally overcomes friction.
    Without the ramp, the step input gives Kp*2.63 = 79 PWM immediately,
    which overcomes deadband cleanly. Kp=30 + Ki=150 + coast-to-stop
    is the pre-reinstall configuration that drove smoothly.
    [main.cpp]
2026-05-15 fix(esp32): add EMA velocity filter to suppress left encoder noise
    Left encoder (GPIO40/41) generates large phantom count bursts (~10+ rad/s
    spikes at 2.63 rad/s target) from motor PWM switching noise coupling into
    encoder signal wires. Without filtering the PID over-corrects against noise
    each tick, causing rapid PWM oscillation perceived as jerky motion.
    EMA filter (alpha=0.2, ~165ms time constant at 30Hz) smooths velocity
    before PID sees it. Left filtered velocity now settles stably to target
    (-2.53 to -2.69 for -2.63 target) vs previous wild swings.
    Root cause fix: route left encoder wires (GPIO40/41) away from motor
    power lines or add 100nF caps encoder-signal-to-GND. Filter is a
    work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
    [main.cpp]
2026-05-15 fix(esp32): smooth motion — EMA filter + cmd ramp + preseed integral
    Three-part fix for jerky motion and fast start after Pi SD reinstall:
    1. EMA velocity filter (alpha=0.2) on encoder feedback before PID.
    Suppresses left encoder EMI noise (GPIO40/41 pick up TB6612 PWM
    switching noise) that caused PID overcorrections and physical jerk.
    2. Command ramp (LIN_ACCEL=0.50 m/s², ANG_ACCEL=1.50 rad/s²) shapes
    the cmd_vel step input before it reaches PID targets. Eliminates
    the startup punch from abrupt target changes. Stop command (cmd=0)
    snaps ramp to zero immediately for crisp 'k'-key stop response.
    3. Integral preseed on rest→move transition: offsets the large initial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
    [main.cpp]
2026-05-15 docs: document fix #31 — jerky motion, EMA filter + cmd ramp + preseed
    Full before/after write-up: root causes (left encoder EMI, command
    step-in, ramp coast), what didn't work (median filter, tight spike
    clip, slow target slew), and the three-part fix with exact constants.
    Includes permanent hardware fix recommendation (100nF caps GPIO40/41).
2026-05-15 docs: update fix #31 with final tuned values and additional techniques
    Add PWM slew limiter, reversal coast, and no-active-braking to the
    fix #31 writeup. Correct constants to final tuned values (LIN=0.35,
    ANG=1.10, SEED=55) matching commit a68a811.
2026-05-15 feat(esp32): add cmd_vel timeout failsafe (500ms)
    If no /diff_cont/cmd_vel_unstamped arrives within 500ms while the
    agent is still connected, cmd_lin and cmd_ang are zeroed. The ramp
    then snaps to zero on the next tick and motors coast to a stop.
    t_cmd_last is reset to 0 on each reconnect so the timeout does not
    fire before the first command arrives in a new session.
    Addresses recommended-improvements.md #1.
    [main.cpp]
2026-05-15 fix(esp32): throttle telnet log to 1Hz; add MIT LICENSE
    Log spam fix: [enc] line was firing at 30Hz, flooding telnet.
    Now logs once per second (every 30 control ticks) — enough to
    monitor live state without drowning real debug output.
    Adds root LICENSE file (MIT) to match README badge. Addresses
    recommended-improvements.md #9 and #21.
    [main.cpp]
2026-05-16 fix(esp32): raise reversal coast threshold, remove no-active-braking, tune timeout
    - REVERSAL_COAST_VEL 0.8 → 3.0 rad/s: left encoder EMI noise was false-triggering
    coast (0.2 × −4 rad/s spike = −0.8, exactly the old threshold), causing stall-restart
    cycles mid-drive by resetting the slew limiter on every noise burst
    - Remove no-active-braking check: also reset slew limiter on noise-induced overshoots;
    slew limiter already caps abrupt PWM changes, making the check redundant
    - CMD_TIMEOUT_MS 500 → 1000 ms: gives more margin above OS key-repeat initial delay
    Teleop fix: use repeat_rate:=10.0 — raw-mode terminal suppresses OS key repeat, so
    without it each held key delivers on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
    [main.cpp]
2026-05-16 fix(motion): restore velocity smoothing via Pi-side vel_smoother node
    diff_drive_controller's 0.5 m/s² / 1.0 rad/s² acceleration limits were
    the missing piece after the SD-card reinstall. Without them, teleop step
    commands reach the ESP32 PID as raw jumps, causing startup punch and jerk.
    - scripts/vel_smoother.py: 50Hz ROS2 node that subscribes to /cmd_vel_raw
    and publishes acceleration-limited commands to /diff_cont/cmd_vel_unstamped
    (0.5 m/s² linear, 1.0 rad/s² angular — exact limits from diff_drive_controller)
    - launch_robot.launch.py: reroute twist_mux → /cmd_vel_raw → vel_smoother → ESP32
    - CMakeLists.txt: install vel_smoother.py
    - main.cpp: remove redundant ESP32 comma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
    [main.cpp, vel_smoother.py]
2026-05-16 fix: mark vel_smoother.py executable
    [vel_smoother.py]
2026-05-16 docs: document fix #33 — vel_smoother restores diff_drive_controller accel limiting
2026-05-16 fix(esp32): remove PWM slew limiter — Pi smoother makes it redundant
    With vel_smoother.py handling command ramps on the Pi side, the ESP32
    slew limiter (PWM_SLEW_PER_TICK=8) was capping the preseed's initial
    55 PWM to 8 PWM — below the ~45 PWM motor deadband. Motors buzzed but
    couldn't start.
    Pi-side smoothing means the PID never sees step inputs, so there is no
    risk of abrupt PWM jumps that slew was protecting against. The EMA
    filter handles EMI spikes on the encoder side.
    [main.cpp]
2026-05-16 PID tuning: Kd=0 Ki=5 preseed; fix vel_smoother SHM startup
    Switch from Kd=12 to Ki=5+preseed: derivative caused ~90% overshoot when
    combined with EMA filter lag on ramp inputs. Preseed initializes integral
    so first tick delivers 55 PWM regardless of ramp step size.
    Launch fix: delay vel_smoother 2s so twist_mux DDS publisher is fully
    established before vel_smoother creates its /cmd_vel_raw subscription.
    FastDDS SHM discovery fails between co-launched processes without this gap.
    Also add PID tuning guide at docs/pid_tuning_guide.md.
    [main.cpp]
2026-05-16 Update CLAUDE.md and pid_tuning_guide for fix #34
    Document Kd removal, Ki+preseed PID, SHM pipeline fix, and
    confirmed starting values with stop-creep tuning guidance.
2026-05-16 Add PID sequence test runner
2026-05-16 Point PID runner at controller topic by default
2026-05-16 Add warmup to PID sequence runner
2026-05-16 Point PID runner at cmd_vel_raw by default
2026-05-16 Refresh docs and PID tuning workflow
2026-05-16 Tighten ESP32 boot arming
    [main.cpp]
2026-05-16 fix(bridge): vel_smoother cmd timeout + Pi-ESP32 comms docs
    Prevents stale DDS history from blocking ESP32 arming guard.
    Updates pi-setup.md service template with missing SHM cleanup.
    Documents stuck micro_ros_agent recovery in workflow.md.
    [vel_smoother.py]
2026-05-16 Consolidate OLED and PID docs
2026-05-16 Fix bridge defaults and clean battery path
    [main.cpp, oled_display_node.py, pid_sequence_test.py]
2026-05-16 Kill stale motion publishers on startup and harden force_stop
    - _kill_stale_motion_publishers() scans for ros2 topic pub/hz processes
    publishing to /cmd_vel_joy, /cmd_vel_raw, /cmd_vel, or
    /diff_cont/cmd_vel_unstamped before the node starts. Stale CLI
    publishers are dangerous when enable_motion:=true is live on the Pi.
    The /diff_cont/cmd_vel_unstamped case is separately called out because
    it bypasses twist_mux and vel_smoother entirely.
    - force_stop() extended from 0.6 s to 1.0 s and publish rate doubled to
    0.05 s intervals. Covers vel_smoother's 0.5 m/s² ramp-to-zero from max
    command speed. Prints status so the teardown is visible in the log.
    - Root cause: leftover ros2 topic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
2026-05-17 Clean repo layout and archive legacy bridge
    [ball_tracker_params_robot.yaml]
2026-05-17 feat(oled): final display layout — DejaVu Mono, dynamic battery, right-align
    - Switch from org01_font pixel font to DejaVuSansMono.ttf (regular, not bold)
    - Row 1 (battery): 11pt — icon + voltage left, current right-aligned
    - Rows 2-4 (IP, status, uptime): 9pt — label left, value right-aligned
    - Dynamic battery icon: 4 bars mapped to 9.0–12.6 V (3S LiPo range)
    - Vertical centering within each 16 px row
    - Right margin 6 px to prevent border clipping
    - Battery icon nudged down 1 px; IP row left padding +1 px
    [oled_display_node.py]
2026-05-17 fix(oled): nudge battery icon up 2px for vertical alignment with row 1 text
    [oled_display_node.py]
2026-05-17 docs: end-of-session update — OLED finalized, motion and feature roadmap documented
2026-05-17 fix(launch): stagger vel_smoother 2s after twist_mux to fix SHM discovery
    Both nodes started at TimerAction(2s) simultaneously, causing FastDDS SHM
    endpoint discovery to fail silently — vel_smoother received no messages from
    twist_mux even though the subscription was registered. Confirmed by direct
    publish to /cmd_vel_raw from dev (UDP path) working while Pi-local SHM path
    dropped all commands.
    twist_mux: T+2s, vel_smoother: T+4s — identical to the original fix #34 intent.
2026-05-17 fix(launch): scope FastDDS no-SHM profile to twist_mux+vel_smoother only
    Applying FASTRTPS_DEFAULT_PROFILES_FILE globally in the service broke the
    micro_ros_agent bridge — it uses an internal DDS config that conflicts with
    the UDP-only profile on loopback. Confirmed: direct pub from dev (default
    profile) reached ESP32; vel_smoother pub (custom profile) did not.
    Fix: use additional_env in Node definitions so only twist_mux and vel_smoother
    use the no-SHM profile. micro_ros_agent keeps its default FastDDS transport.
2026-05-17 fix(launch): no-SHM profile on twist_mux only, not vel_smoother
    vel_smoother with UDP-only profile breaks the micro_ros_agent DDS bridge —
    micro_ros_agent uses default FastDDS (SHM+UDP) and its loopback UDP discovery
    with the custom profile was silently failing. Result: vel_smoother published
    correct values visible on the DDS bus but micro_ros_agent never forwarded them
    to the ESP32 over serial.
    Fix: only twist_mux gets the no-SHM profile (breaks the stale-SHM race vs
    vel_smoother). vel_smoother and micro_ros_agent both use default FastDDS and
    communicate via SHM as intended. ExecStartPre already clears stale SHM segments
    before each start so the vel_smoother↔micro_ros_agent SHM path is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
2026-05-17 Add no-SHM profile to vel_smoother to fix Pi-local UDP delivery to micro_ros_agent
    vel_smoother → micro_ros_agent SHM data delivery was silently failing (DDS
    discovers both endpoints but no data flows). Dev machine UDP delivery works,
    confirming micro_ros_agent receives UDP fine. Applying UDP-only profile to
    vel_smoother forces it to publish via UDP loopback, which micro_ros_agent
    receives via its default SHM+UDP subscription.
2026-05-17 Fix CMD_TIMEOUT false-trigger: refresh now after executor_spin
    rclc_executor_spin_some can block up to 10ms. cmd_cb fires inside it
    and sets t_cmd_last = millis() (current time). The outer now was captured
    at loop() top — now < t_cmd_last → uint32 subtraction underflows →
    (now - t_cmd_last) appears huge → CMD_TIMEOUT fires every control tick,
    repeatedly disarming motion_armed.
    Fix: refresh now = millis() immediately after executor_spin so
    now >= t_cmd_last is guaranteed before the CMD_TIMEOUT check.
    [main.cpp]
2026-05-17 Update CLAUDE.md: bench test verified, fix #37/#38 history
    Bench test passed 2026-05-17: both wheels track 5.88 rad/s (0.2 m/s forward),
    encoder counts 3135/3131, vel_smoother ramp visible. Motion pipeline fully
    functional. Next: floor test.
    Document fix #37 (vel_smoother UDP-only to fix same-host SHM delivery) and
    fix #38 (CMD_TIMEOUT uint32 underflow from stale now vs fresh t_cmd_last).
2026-05-17 Reduce CONNECTED-state ping timeout from (500,3) to (200,1)
    (500, 3) = up to 1.5s stall in the main loop while motors may be active.
    During that window: no PID updates, no cmd processing, no odom/IMU publish,
    no ArduinoOTA. At steady speed this is hidden; during turns or on agent loss
    it is an uncontrolled open-loop interval.
    (200, 1) caps the stall at ~200ms. One missed ping is sufficient to declare
    the agent unhealthy in CONNECTED state; the reconnect path stops motors and
    returns to WAITING, which is conservative and safe.
    WAITING-state ping stays at (500, 3) — acceptable there since motors are off.
    [main.cpp]
2026-05-17 Fix agent-lost handler: use reset_motion_state() + increase ping to (500,1)
    - In CONNECTED ping handler: replace scattered manual reset (pid targets,
    motion_armed, zero_hold_start, motors_stop) with reset_motion_state().
    reset_motion_state() also clears vel_l_filt/vel_r_filt, cmd_lin/cmd_ang,
    t_cmd_last, enc counters, and odom — preventing stale filter state from
    corrupting PID output on the first tick after reconnect.
    - Change rmw_uros_ping_agent(200, 1) → (500, 1) in CONNECTED state.
    200ms empirically too tight under floor motor load (3 false disconnects in
    first 40s floor test). 500ms/1 attempt caps block at ~500ms while providing
    more tolerance for serial jitter. WAITIN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
    [main.cpp]
2026-05-17 Add floor_baseline profile + document DDS multi-invocation blocker
    floor_baseline runs all four counted moves (fwd 1m, bwd 1m, left 360°,
    right 360°) in one process so DDS matching is established once per pass
    rather than once per separate one_turn invocation. Participant churn after
    each process exit was causing command delivery to silently fail on all
    subsequent invocations despite the ESP32 Telnet stream remaining live.
    Changes:
    - pid_sequence_test.py: Step gains goal_counts/max_counts fields; count-
    based stop generalised to any step with goal_counts>0; floor_baseline
    profile creates 4 counted steps with inter-step encoder reset + warmup;
    arm/preflight/warmup/_advance all keyed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
    [after_esp_recovery_route_validation.csv, floor_baseline_1_backward.csv, floor_baseline_1_forward.csv, floor_baseline_1_left_360.csv, floor_baseline_1_right_360.csv, floor_baseline_2_backward.csv, floor_baseline_2_forward.csv, pi_route_validation_after_safety_patch.csv]
2026-05-18 Fix inter-step encoder reset disarming ESP32; add IMU columns to CSV
    Three fixes in one commit:
    ESP32 (main.cpp):
    - Split reset_motion_state() into reset_encoder_state() (enc+PID+odom only)
    and reset_motion_state() (full, used on agent reconnect). Telnet 'r' command
    now calls reset_encoder_state() so it no longer clears motion_armed,
    t_cmd_last, or zero_hold_start. Previously 'r' disarmed the robot between
    floor_baseline steps, causing all bwd/spin steps to time out at 0 counts.
    - Convert BNO055 VECTOR_GYROSCOPE output from dps to rad/s before publishing
    to /imu/imu. angular_velocity fields now carry correct SI units.
    (imu_enc_ang_err_avg dropped from 51 to 0.078 rad/s after fix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
    [2026-05-17_run_001.csv, 2026-05-17_run_002.csv, 2026-05-17_run_003.csv, 2026-05-17_run_004.csv, after_esp_recovery_route_validation.csv, floor_baseline_1_backward.csv, floor_baseline_1_forward.csv, floor_baseline_1_left_360.csv]
2026-05-18 Repo audit fixes: safety, metadata, portability, code quality
    - Redact WiFi/OTA credentials in CLAUDE.md (replace with placeholders)
    - Fix Nav2/vel_smoother acceleration mismatch: align DWB and Nav2
    velocity_smoother limits to 0.5 m/s² / 1.0 rad/s² to match the
    actual robot envelope enforced by vel_smoother.py
    - Fix package.xml: correct maintainer, description, and license (MIT)
    - Parameterize ESP32 serial path as launch arg with by-id default
    - Update stale PID constants in CLAUDE.md to current firmware values
    (KP=28, KI=9, KI_MAX=12, START_PWM_SEED=60, RUN_PWM_FLOOR=55)
    - Cache _ros_status() result 5s to avoid subprocess fork at 2 Hz
    - Fix DEFAULT_LOG hardcoded path in pid_sequence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
    [ros2_control.xacro]
2026-05-18 ESP32 control loop: 100Hz PID, 921600 baud, decoupled 30Hz odom publish
    - Serial.begin 115200 → 921600; micro_ros_agent -b 921600 flag added
    - rclc_executor_spin_some timeout 10ms → 1ms (reduces cmd latency jitter)
    - Motor PID rate 30Hz → 100Hz (CONTROL_PERIOD_MS=10); odom+IMU publish
    stays at 30Hz (ODOM_IMU_PERIOD_MS=33) via separate timer t_odom_imu
    - Odom position accumulation kept in 100Hz block — critical correctness fix:
    moving it to the 30Hz gate would discard ~67% of encoder counts
    - Logging throttled to 5Hz (LOG_PERIOD_MS=200) via t_log; replaces log_tick
    - Odom twist uses vel_l_filt/vel_r_filt (already global, updated every tick)
    - platformio.ini monitor_speed updated t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
    [main.cpp]
2026-05-18 Apply post-audit fixes: covariance, battery status, WiFi timeout, dead code
    ESP32 main.cpp:
    - Set odom pose/twist covariance diagonals (x, y, yaw, vx, omega = 0.001)
    instead of leaving all-zeros (zero = infinite precision to the EKF)
    - Battery power_supply_status now dynamic: CHARGING (1) when i>0.05A,
    DISCHARGING (2) otherwise — was hardcoded to DISCHARGING always
    - WiFi connect loop now has 10s timeout; robot boots and starts micro-ROS
    over USB even if router is unavailable (OTA/TelnetStream will be absent)
    - Add comment on VEL_ALPHA 100Hz re-tuning: if jitter returns try 0.06
    oled_display_node.py:
    - Remove dead _text_width() method that referenced undefined org_text_width
    CLAUDE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
    [main.cpp, oled_display_node.py]
2026-05-18 Tune VEL_ALPHA for 100Hz control loop: 0.2 → 0.06
    EMA time constant T = dt/alpha. At 30Hz alpha=0.2 gave T≈165ms.
    At 100Hz the same alpha gives T≈50ms — 3× less filtering, causing
    larger PID corrections from the same EMI noise events. alpha=0.06
    at 100Hz restores T≈167ms, equivalent noise suppression to before.
    [main.cpp]
2026-05-21 Retune PID and add IMU outer-loop angular correction
    Firmware (main.cpp):
    - KP 28→55, KI 9→15, KI_MAX 30→40 — robot now reaches 90%+ of commanded
    wheel speed (enc_ratio 0.91); spin accuracy 95-99% vs 87% before
    - VEL_ALPHA 0.06→0.3 — TB6612 ground wire reconnected, EMI noise gone at source
    - REVERSAL_COAST_VEL 3.0→0.5 — threshold was inflated to mask noise, now correct
    - IMU outer-loop angular correction (K_ANG_OUTER=0.5): gyro_z_filt feeds
    per-wheel PID target differential at 100Hz for heading hold and spin tracking
    - IMU correction gated on active motion — suppressed when cmd=0 so picking up
    or bumping the robot does not trigger motor output
    Test script (pid_sequen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
    [main.cpp, pid_sequence_test.py]
2026-05-21 fix bridge_cmd_max_gap: raise CMD_FRESH_FOR_PING_MS above CMD_TIMEOUT
    CMD_FRESH_FOR_PING_MS was 750ms. vel_smoother delivers at ~37Hz avg so
    natural DDS jitter could cause cmd_age > 750ms during active motion,
    triggering rmw_uros_ping_agent(500ms) which blocks the shared serial
    transport — total gap ~1.029s = 750ms age + ~279ms ping.
    Fix: raise CMD_FRESH_FOR_PING_MS to 3500ms (above CMD_TIMEOUT_MS=3000ms)
    so the ping only fires when motors are already stopped by the timeout.
    Also reduce ping timeout 500ms → 100ms to minimize serial blocking if
    the agent does go silent.
    [main.cpp]
2026-05-21 add cmd_cb gap instrumentation; fix telnet buffering; parse fw gap
    - TelnetStream.flush() after [cmd] log forces immediate TCP send
    - cmd_cb tracks running max gap (ms) between consecutive DDS deliveries
    - gap= field added to [enc] telnet log line, resets on 'r' encoder reset
    - ENC_LINE_RE extended to parse gap field; fw_cmd_gap_ms reported in summary
    Result: fw_cmd_gap_ms=10391 is purely the boot-delay (vel_smoother 4s
    TimerAction + DDS discovery). No real DDS gap during active testing.
    bridge_cmd_max_gap_s=1.026 was always TCP telnet buffering artifact.
    DDS delivery is clean; CMD_FRESH_FOR_PING_MS=3500 fix is sufficient.
    [2026-05-19_run_005.csv, 2026-05-19_run_006.csv, 2026-05-19_run_007.csv, 2026-05-19_run_008.csv, 2026-05-19_run_009.csv, 2026-05-19_run_010.csv, 2026-05-20_run_011.csv, 2026-05-20_run_012.csv]
2026-05-21 switch floor_baseline spin steps to encoder-count-based termination
    Spin steps now terminate when both wheels accumulate spin_counts encoder
    counts rather than after a fixed time. This eliminates the dependency on
    PID tracking efficiency (enc_ratio) for spin accuracy.
    spin_counts = rotations × (WHEEL_SEP/2) / WHEEL_RADIUS × counts_per_rev
    = 4 × 0.0895/0.034 × 1010 = 10634 counts
    Duration is set to 2× the kinematic time as a generous timeout.
    Warmup is reduced to 1.0s (--warmup 1.0 in command) since count-based
    steps enter a warmup phase on each step; stop_hold=2.0s already
    provides sufficient settling time between steps.
    run_025 result: left=106.1%, right=104.9% — tight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
    [2026-05-20_run_025.csv]
2026-05-22 pid_sequence_test: IMU-primary spin stop + full sensor fusion cross-validation
    Spin steps (floor_baseline) now terminate on IMU gyro integral (actual body
    rotation) rather than encoder counts alone. Encoder count termination kept as
    fallback before first IMU sample arrives.
    Per-step report now includes all three sensor sources:
    - IMU: gyro_total, expected, delta, accuracy %
    - Encoder: cnt_l/cnt_r at stop, encoder-derived body rotation, slip vs IMU
    - INA219: per-step min voltage and peak current
    New derived metrics per spin step:
    - enc_rot_deg: encoder-derived body rotation (cross-check against IMU)
    - slip_deg: enc_rot - |gyro| (negative = encoder undercount / positive = wheel slip)
    - eff_c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
    [pid_sequence_test.py]
2026-05-22 test-results: floor_baseline runs 027-031 — PID validation complete
    Runs 027-030: standard speed (0.35 m/s / 1.5 rad/s), --turn-counts-per-rev 977
    IMU-primary spin accuracy: 100.0-100.7% across 4 runs (±0.4% spread)
    Straight-line drift: -3.2° to +1.8° per 0.4m
    Run 031: slow speed (0.20 m/s / 1.0 rad/s)
    Spin accuracy: 100.1% both directions
    enc_ratio 0.906/0.952 (better PID tracking at lower speed)
    No stall, no oscillation at reduced speed
    PID KP=55/KI=15 declared tuned. Next: lidar-assisted tuning.
    [2026-05-21_run_026.csv, 2026-05-21_run_027.csv, 2026-05-21_run_028.csv, 2026-05-21_run_029.csv, 2026-05-21_run_030.csv, 2026-05-21_run_031.csv]
2026-05-22 docs: PID tuning complete — update CLAUDE.md for lidar-assisted next phase
    PID declared tuned (KP=55/KI=15, runs 027-031).
    CLAUDE.md: current state updated to 2026-05-21; next steps rewritten to
    lidar-assisted tuning with full launch sequence. Figure-eight profile
    deferred (lidar will provide better arc ground truth than IMU alone).
2026-05-22 fix: add joint_state_publisher to dev_launch — restore wheel TF for RViz
    ESP32 micro-ROS path publishes odom directly without joint states.
    Without joint_state_publisher, robot_state_publisher has no data to compute
    left_wheel/right_wheel TFs — RViz RobotModel shows red errors on both wheels.
    Fix: add joint_state_publisher node to dev_launch.py (publishes zero
    wheel positions). Nav stack doesn't use wheel TF; this is display-only.
    Requires: ros-humble-joint-state-publisher
2026-05-22 slam: reduce map resolution 0.025 → 0.01 m/pixel for finer detail
    2.5cm pixels were too coarse for the 4x4ft test space.
    1cm pixels give 2.5x finer detail for lidar-assisted PID tuning.
2026-05-22 fix ekf: disable encoder absolute yaw — use IMU gyro for heading
    odom0_config had yaw=true, fusing encoder-accumulated heading into the EKF.
    During 4×360° spins the right encoder undercounted by 84° due to wheel slip,
    making the accumulated encoder heading badly wrong. The EKF blended this with
    the IMU gyro rate, dragging the pose estimate and causing SLAM drift of ~12.7°.
    With yaw=false, heading is estimated by integrating velocity inputs only (IMU
    gyro dominates). Spin SLAM drift drops from 12.7° to 4.3°; both wheel eff_cpr
    values now consistent at 993/994 (were 920/960 with asymmetric slip pollution).
    [ekf.yaml]
2026-05-22 revert ekf: restore encoder absolute yaw in odom0_config
    Removing odom0 yaw caused 90° heading drift during spinning — pure velocity
    integration over 8 full revolutions diverges without an absolute anchor.
    The encoder yaw (even at ~12.7° error) kept SLAM stable enough to track the
    robot through the spin sequence. Reverted to original odom0_config yaw=true.
    The SLAM drift during spinning is a scan-matching ambiguity problem in a small
    symmetric environment, not an EKF tuning problem. SLAM validation should focus
    on straight-line steps where it gives useful ground truth; spinning is already
    validated accurately by IMU.
    [ekf.yaml]
2026-05-22 esp32: raise odom pose yaw covariance 0.001→0.1
    Encoder-accumulated heading has significantly higher real-world error than
    the claimed 0.001 variance — especially during spinning where wheel slip
    causes undercounting. EKF was over-weighting the encoder absolute heading
    against the IMU angular velocity, causing large SLAM position drift (22cm).
    Raising pose.covariance[35] to 0.1 (100x less confident) lets the IMU gyro
    rate dominate heading estimation during spinning. SLAM position error drops
    from ~22cm to ~5cm. Twist angular velocity covariance kept at 0.001 since
    instantaneous encoder rate is more reliable than the accumulated heading.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
    [main.cpp]
2026-05-22 fix ekf: disable IMU linear acceleration (imu0 ax)
    BNO055 accelerometer noise double-integrates to position drift when the
    robot is stationary. For a 2D differential drive robot, wheel odometry
    provides better position tracking than accelerometer integration. Only
    the IMU gyro angular velocity is needed from the IMU — ax adds noise
    without meaningful benefit and caused visible robot drift in RViz while
    sitting still after a session of heavy spinning.
    [ekf.yaml]
2026-05-22 add scan_gate, localization params, and 2026-05-22 test results
    - scan_gate.py: drops lidar scans when |wz| > 0.3 rad/s to prevent
    slam_toolbox from ingesting motion-distorted scans during spinning
    - mapper_params_localization.yaml: slam_toolbox localization mode config
    with /scan_gated topic and wider coarse_search_angle_offset (1.05 rad)
    - CMakeLists.txt: install scan_gate.py
    - floor_baseline runs 032-041: session data including sensor isolation tests
    [2026-05-22_run_032.csv, 2026-05-22_run_033.csv, 2026-05-22_run_034.csv, 2026-05-22_run_035.csv, 2026-05-22_run_036.csv, 2026-05-22_run_037.csv, 2026-05-22_run_038_straight.csv, 2026-05-22_run_039.csv]
2026-05-22 esp32: correct ENC_CPR 1010→990, disable IMU outer-loop (K_ANG_OUTER=0)
    ENC_CPR: measured left=989, right=985 counts/rev by manual rotation;
    theoretical 11PPR × 2 × 45:1 = 990 confirms the 2.1% odometry over-estimate.
    K_ANG_OUTER: set to 0.0 — outer-loop correction caused spin overshoot
    (+6.9°→+0.8° improvement) with no eff_cpr benefit; disabled permanently.
    Test results: runs 042-045 (2026-05-22) — CPR correction and outer-loop
    isolation tests.
    [2026-05-22_run_042.csv, 2026-05-22_run_043.csv, 2026-05-22_run_044.csv, 2026-05-22_run_045.csv]
2026-05-23 docs: RPLIDAR A1M8 motor stop script + hardware docs; ENC_CPR/K_ANG changelog
    - scripts/lidar_stop_motor.sh: new executable script to stop lidar motor
    via /stop_motor ROS2 service (only supported software path on A1M8)
    - docs/pin-mapping.md: add full RPLIDAR A1M8 hardware interface section
    (motor/core/CP2102 pins, key specs, motor stop procedure, boot default);
    fix ENC_CPR constant from 1010 to 990
    - CLAUDE.md: changelog entries 39 (ENC_CPR 1010→990, K_ANG_OUTER disabled,
    eff_cpr asymmetry root cause) and 40 (A1M8 motor stop procedure, lidar
    disabled at boot, hardware ref from LD108/LM108 datasheets)
